mkolakovic/Self-Protected-Output-Driver-with-Feedback/img/uc_out.jpg

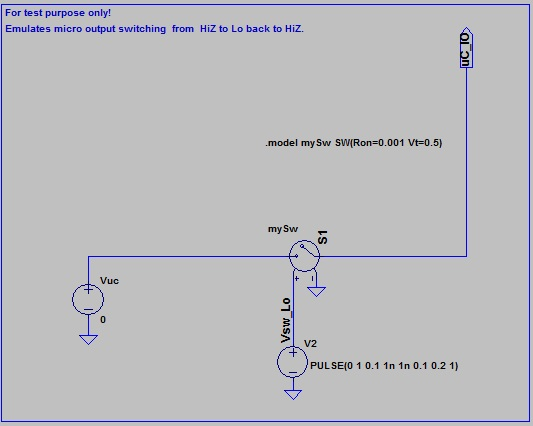
img/uc_out.jpg
