mkolakovic/Self-Protected-Output-Driver-with-Feedback/BiDir_Disc_IO_5V.asc

Load: res; 47
Q1: pnp
Q2: npn
R1: res; 1K
R2: res; 10k
R3: res; 1.2K
R4: res; 21.8K
R5: res; 10K
S1: sw; mySw
S4: sw; mySw
Short: res; 4.7
V1: voltage; 5v
V2: voltage; PULSE(0 1 0.1 1n 1n 0.1 0.2 1)
V4: voltage; PULSE(0 1 0.35 1n 1n 0.05 0.1 1)
Vuc: voltage; 0
Named nets: 0, uC_IO, Vout, Vsw_Lo, Q2_Vb, Q1_Vb, Vsw_short
.tran 0.5s startup
.model mySw SW(Ron=0.001 Vt=0.5)
For test purpose only!
Emulates micro output switching  from  HiZ to Lo back to HiZ.
.model mySw SW(Ron=0.001 Vt=0.5)
For test purpose only!
Emulates Load and short to ground condition.
Self Protected Output Driver with Feedback
