mkolakovic/Self-Protected-Output-Driver-with-Feedback/img/test_circuit.jpg

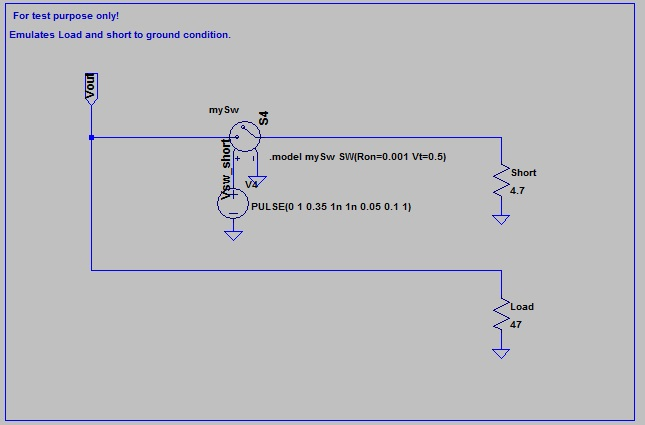
img/test_circuit.jpg
